rokset3/Pump-Project/README.md

### Fluid Transportation Network
Freshman Year project
  Project was done with Rapsberry Pi.
The video-demonstration is available here: https://drive.google.com/file/d/17SKNj82ii3UFRnJPJWQ1BqKj5DRgUxJs/view?usp=sharing
Code, 3D models of the pump available above.
