rokset3/Pump-Project/Group16_Models/static.stl

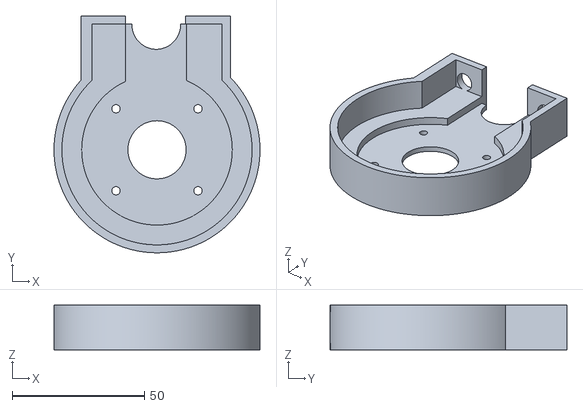
[picture p2: CAD file, 2022-06-01]
Group16_Models/static.stl
78.0 x 89.6 x 17.0
