rokset3/Pump-Project/Group16_Models/spinnernew.stl

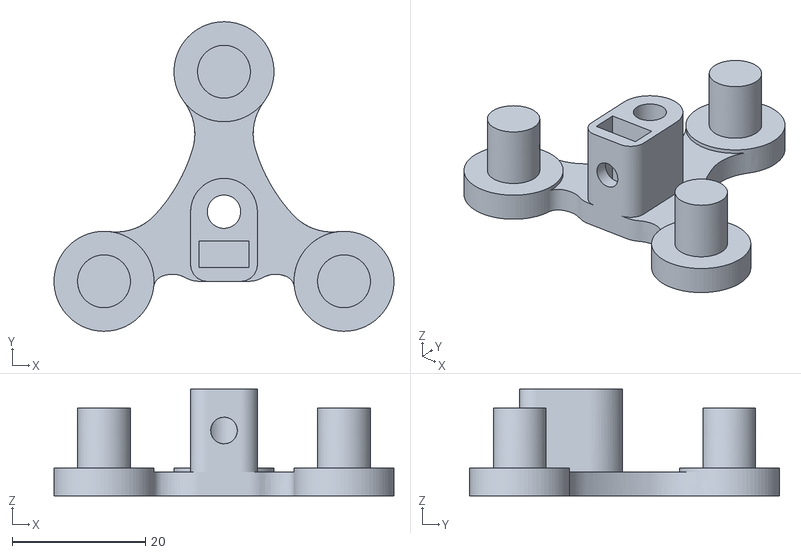
[picture p3: CAD file, 2022-06-01]
Group16_Models/spinnernew.stl
51.0 x 46.4 x 16.0
