rokset3/Pump-Project/(list of files, cad)

Other CAD files:
Group16_Models/spinner.3dm
Group16_Models/static.3dm
